microresearch/gamma/notes.org

* edition of 60. price 225

* costs - euros

- tube 12
- castings resin/casts (20 casts say 100=5+costs=10) 10
- pitchblend 12

- parts approx 15 
- thru-hole 2xswitch, 3xpoti, 5x jacks 3
- knobs x3= 2
- pcb/panel 20
- manual/cables/screws 3
- postage and packings 6+1 say= 7

excess costs say 10
production costs 20

TOTAL: 114!

* old notes here// see README.org in src

** 24/11

- gamma.c basic tests and see if need to redesign for ICP but probably not as is not so critical time-wise

- q of transistor FJN which doesn;t seem to work (BUL216 is fine) - if is just resistor Q/trim for every case?

problem was we have FJN3303R which has a resistor inside it

- programs fuse fine// TEST all TODO!

* PSU

mightyohm vs. libellium/sparkfun vs. CCFL

mightyohm equivs: 

1N4937 - NTE552
FJN3303F - STX13001/3/5, MJE13005, FJP13009, BUL216
1N914 - 1N4148 
2N3904 - 2N2222

555 must be CMOS - TLC 555 smd

NOT USE- [for CCFL use 1W 200v zeners and 10Nf 1kv caps... (also for libel/sparkfun)]

SBM-20 - 400v (350-450), dead time = 190 microsec, 4.7M anode resistance

- add LED and serial out for testing

so far on mightyohm - 16.6 k (10k+3x2.2) gives 400v approx and works fine. DECOUPLE PSU

sparkfun - works with crossover transformer (also rising edge for detection)

both seem give same kind of results with sources...

*decided on 555//mightyohm and check all versions*

* PCB

110 mm high max, width=60.6 minus ... say 50.6

* panel

*128.5 mm high // wide=12hP 60.6mm*

perspex...

size as need separate digital from HV PSU and tube!

* TODO

- PSU tests and schematic DONE - footprints to watch: switch, all transistors, fuse holder, pots, jacks...DONE

- footprints for switch, fuse-geiger holder(from gieger.brd we now have)DONE, add outline for sample holder/resin block

SMD equivs MIGHTYOHM - 555 CMOS only, 3904=MMBT3904, FJNand1N4937=noSMD - or STN0214 

- FALLING edge interrupt - test new additions following (also raw stretched geiger is protected and we have LED raw out to TEST) DONE

1ms for stretch

- note pay attention to which are HV components!

see: https://dl.dropboxusercontent.com/u/3572198/GK%20v5.5/GK%20v5.5%20Schematic.png

- sample size and placement and casting of?

* parts list and ordering info

res and some mouser switches

| 1 uF         C4        ;             
| 1.5K         R22       ; x -reichX                        
| 100K         R13       ;             
| 100K         R19       ;             
| 100K         R20       ;             
| 100N         C1        ;             
| 100N         C5        ;             
| 100N         C6        ;             
| 100N         C9        ;             
| 100N         C13       ;             
| 100N         C19       ;             
| 100N         C20       ;             
| 10K          R1        ;             
| 10K          R8        ;             
| 10K          R9        ;             
| 10K          R21       ;             
| 10N          C12       ;             
| 10nF         C21       ;             
| 10nF 1000V   C18       ; x-> mouser   S103M47Z5UN63J7RX  X       
| 10R          R16       ;             
| 10uF         C14       ; x             
| 121K         R10       ; x - reichX           
| 16 MHz       X1        ; x -reichX            
| 1K           R2        ;             
| 1K           R3        ;             
| 1K           R4        ;             
| 1K           R11       ;             
| 1K           R14       ;             
| 1K           R15       ;             
| 1K           R23       ;             
| 1K           R24       ;             
| 1N4148       D11       ; x - thru hole x -reich                                   X
| 1N4937       D10       ; x - thru hole x -reich                                   X      
| 1N914        D9        ; x - thru hole x -reichX                   
| 1nF          C17       ;             
| 1uF          C15       ;             
| 22 pF        C2        ;             
| 22 pF        C3        ;             
| 220K         R12       ; x -reich X                       
| 2n3904-smd   Q1        ; x- MMBT3904Xsegor            
| 2n3904-smd   Q3        ;             
| 330pF 1000V  C16       ; x -mouser?    S221K25Y5PN6TK5R X        
| 33K          R7        ; x -reichX                        
| 4.7M         R18       ; x -reichX                       
| 47N          C7        ; x -reichX  X7R-G0805 47N                                  
| 47N          C8        ;                                    
| 56K          R5        ; x -reichX                                   
| 56K          R6        ;             
| 6.8R         R17       ; x -reichX                                   
| 74HC14       U8        ; x -reichX                                   
| 7805         U4        ; x -reichX                                   
| AUDIO-JACKERTHENVAR_ERTHENVAR-JACK U1        ;             
| AUDIO-JACKERTHENVAR_ERTHENVAR-JACK U2        ;             
| AUDIO-JACKERTHENVAR_ERTHENVAR-JACK U5        ;             
| AUDIO-JACKERTHENVAR_ERTHENVAR-JACK U6        ;             
| AUDIO-JACKERTHENVAR_ERTHENVAR-JACK U9        ;             
| CONN_1       P3        ; pin X           
| CONN_1       P4        ; x fuse holder is mouser: 576-01020074Z x2 X
| CONN_1       P5        ; x as above            
| CONN_2       P6        ; 2pin X           
| CONN_5       P1        ; progpins X           
| CONN_5X2     P2        ; 10 pin x -reichMPE 087-2-010X                                   
| CP           C10       ; ? x 10uF           
| CP           C11       ; ? x 10uF           
| DIODE        D7        ; ? x protection as on all=  - mouser 1N5819HW-7-F X
| DIODE        D8        ; ? x           
| FJN3303F     Q2        ; x 0- mouser X           
| INDUCTOR     L1        ; x -reich  L-11P 10M X                                  
| LED          D12       ; x -reich X                                  
| MEGA48/88/168-AU IC1     x -reich  X                       ; avr-4-TQFP32-08
| POT          RV2       ;             
| POT          RV3       ;             
| SWITCH_INV   SW1       ; x-segor X            
| SWITCH_INV   SW2       ; x-segor X           
| TL072        U3        ; x -reich  TL 072 CD SMD X                                  
| TLC555N      U7        ; x -reich X                                  
| ZENER        D1        ; x incoming zeners MOUSER = input clamp now bat854sw: BAT854SW115 X
| ZENER        D2        ; 3 each            
| ZENER        D3        ;             
| ZENER        D4        ;             
| ZENER        D5        ;             
| ZENER        D6        ;             

* manual/software notes

Extending the explorations of material process and ever viral code
initiated by the micro_research ERD series, ERD/γ digs the Eurorack
synth deep into geological time scales of radioactive decay.

half life... randomness quotes... references

about pitchblende - diagram

https://en.wikipedia.org/wiki/Uraninite

add half-life tables/explain(pitchblend)... module needs to be recalibrated after
x billion years// dosage table // image photo exposure // dosage chart

software: 

jacks: trigger out, out
CV: speed, scale, trigger
pot: speed, scale

document modes on switches: 
00/ scaled random every speed time
01/ scaled random every random time scaled by speed
NO!10/ pulse 5v every x scaled random time
11/ 5v trigger in gives last random voltage
