microresearch/gamma/gamma001_revised.pdf

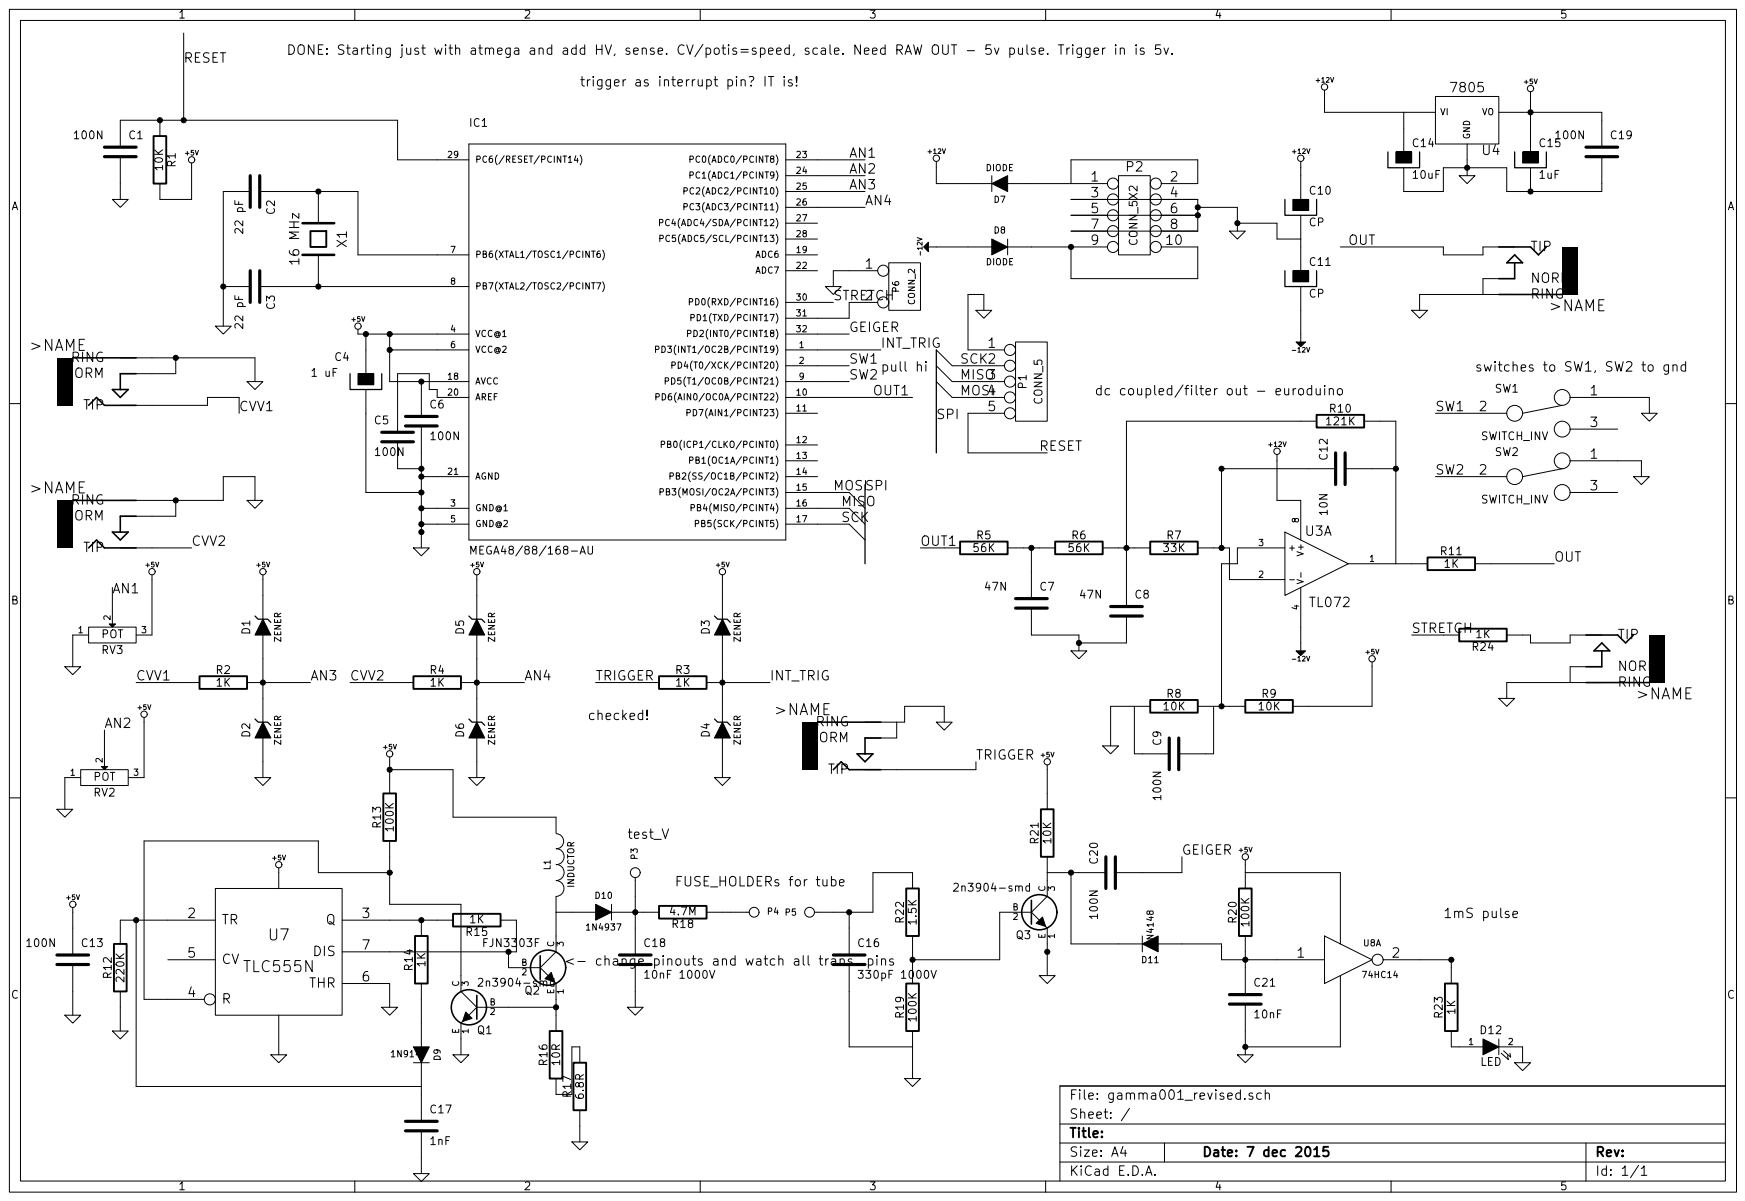
[picture p5: page 1]
