microresearch/gamma/gamma001.sch

## KiCad design gamma001.sch (2015-12-09, an earlier design)

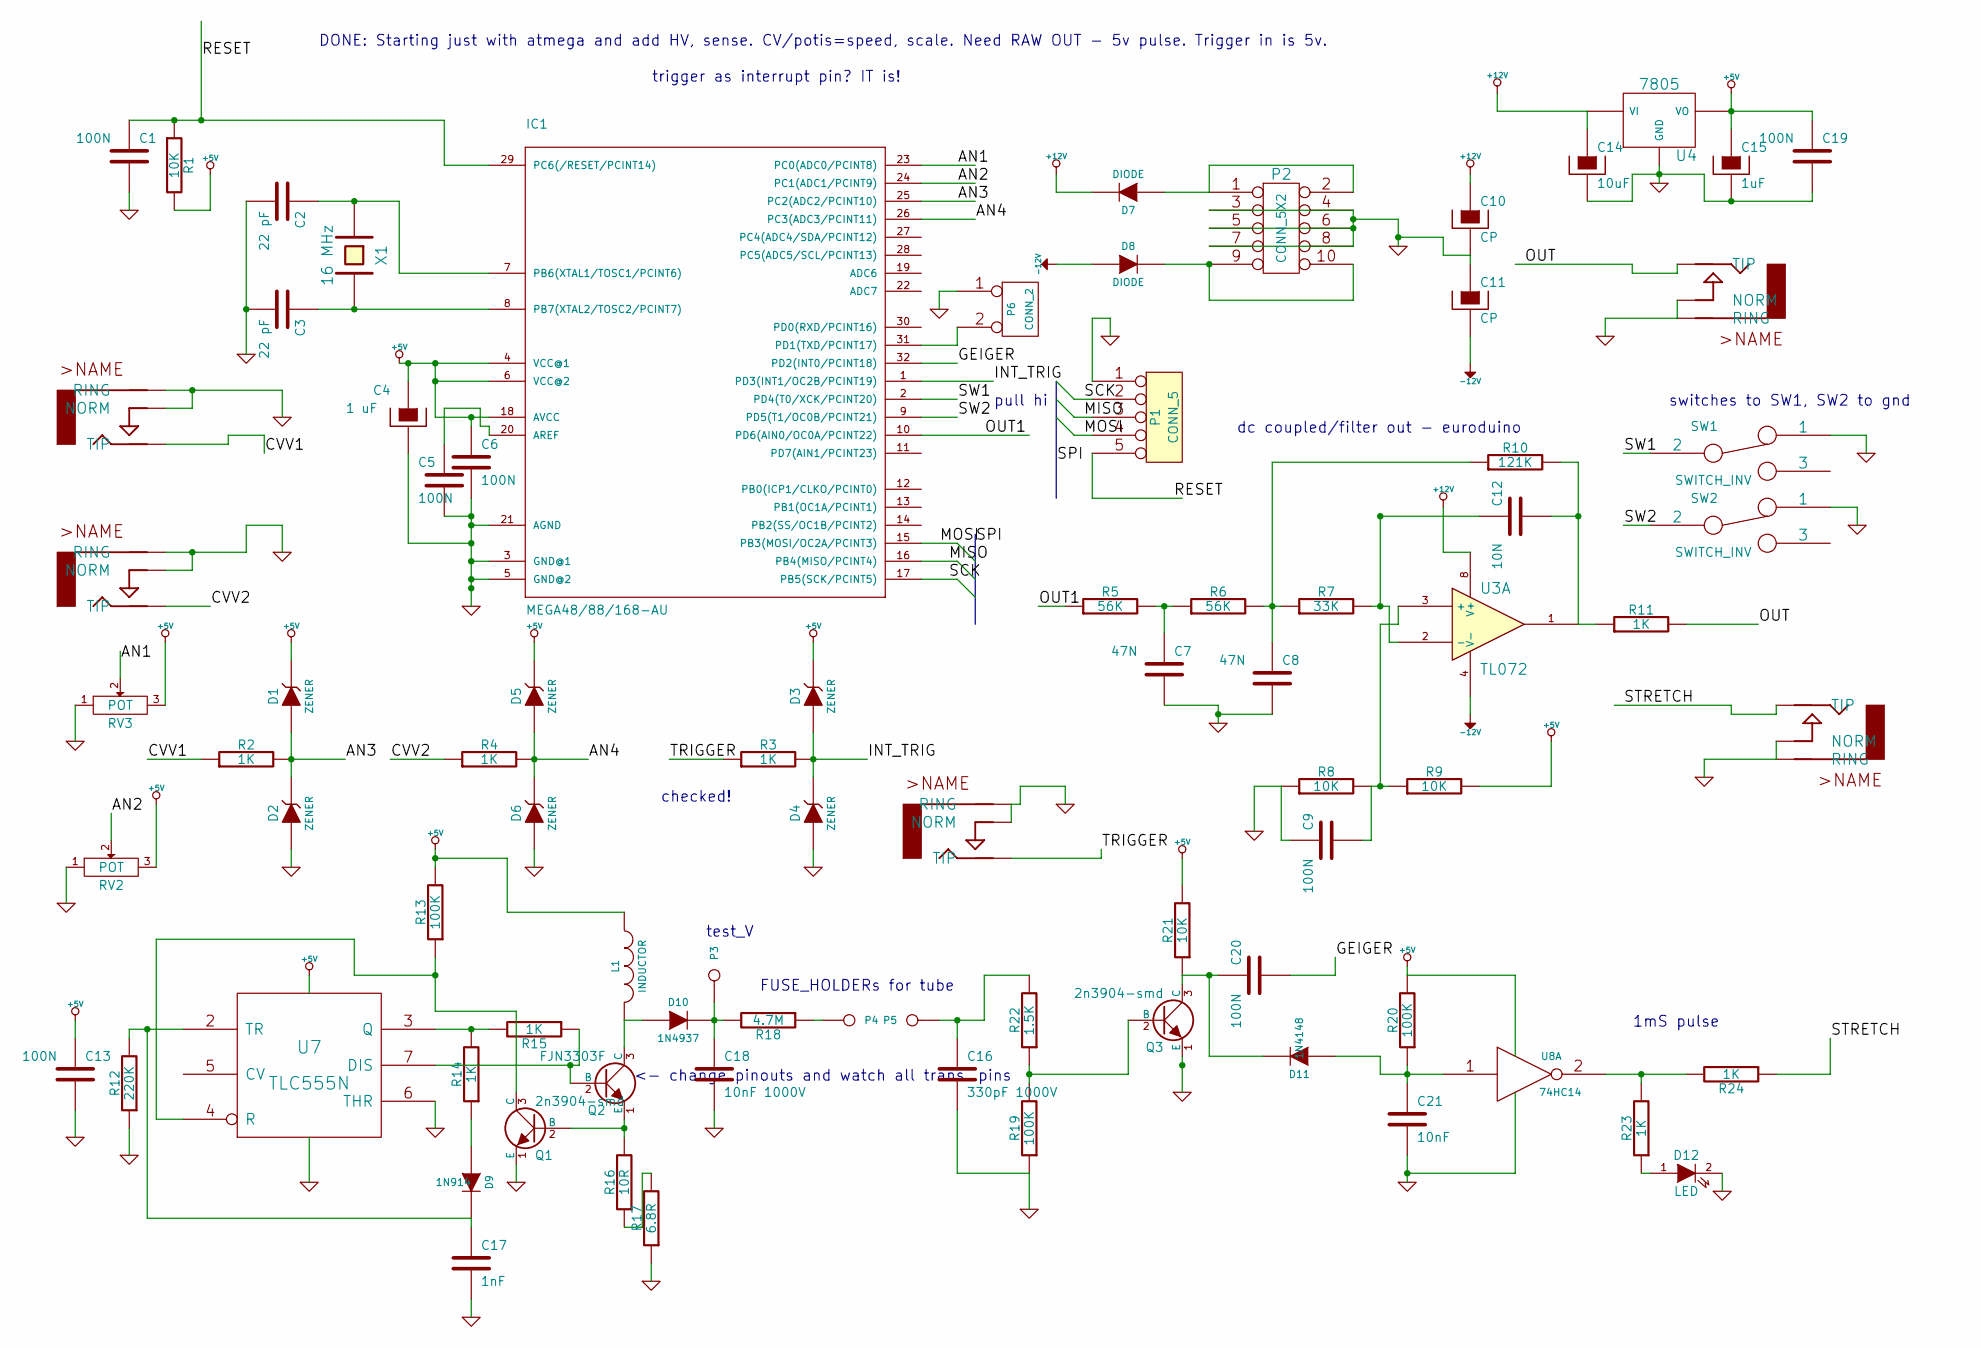
[picture p6: schematic gamma001.sch]

Parts:
C1, C5, C6, C9, C13, C19, C20: 100N
C2, C3: 22 pF
C4: 1 uF
C7, C8: 47N
C10, C11: CP
C12: 10N
C14: 10uF
C15: 1uF
C16: 330pF 1000V
C17: 1nF
C18: 10nF 1000V
C21: 10nF
D1, D2, D3, D4, D5, D6: ZENER
D7, D8: DIODE
D9: 1N914
D10: 1N4937
D11: 1N4148
D12: LED
IC1: MEGA48/88/168-AU; avr-4-TQFP32-08
L1: INDUCTOR
P1: CONN_5
P2: CONN_5X2
P3, P4, P5: CONN_1
P6: CONN_2
Q1, Q3: 2n3904-smd
Q2: FJN3303F
R1, R8, R9, R21: 10K
R2, R3, R4, R11, R14, R15, R23, R24: 1K
R5, R6: 56K
R7: 33K
R10: 121K
R12: 220K
R13, R19, R20: 100K
R16: 10R
R17: 6.8R
R18: 4.7M
R22: 1.5K
RV2, RV3: POT
SW1, SW2: SWITCH_INV
U1, U2, U5, U6, U9: AUDIO-JACKERTHENVAR_ERTHENVAR-JACK
U3: TL072
U4: 7805
U7: TLC555N
U8: 74HC14
X1: 16 MHz

Connections:
+5V: C4.1, C6.1, C13.1, C15.1, C19.1, D1.2 (K), D3.2 (K), D5.2 (K), IC1.4 (VCC@1), IC1.6 (VCC@2), IC1.18 (AVCC), L1.1, R1.2, R9.2, R13.2, R20.2, R21.2, RV2.3, RV3.3, U4.VO, U7.8 (VCC), U8.14 (VCC)
+12V: C10.1, C14.1, D7.2 (K), U3.8 (V+), U4.VI
-12V: C11.2, D8.1 (A), U3.4 (V-)
AN1: IC1.23 (PC0(ADC0/PCINT8)), RV3.2
AN2: IC1.24 (PC1(ADC1/PCINT9)), RV2.2
AN3: D1.1 (A), D2.2 (K), IC1.25 (PC2(ADC2/PCINT10)), R2.2
AN4: D5.1 (A), D6.2 (K), IC1.26 (PC3(ADC3/PCINT11)), R4.2
CVV1: R2.1, U6.3 (TIP)
CVV2: R4.1, U1.3 (TIP)
GEIGER: C20.2, IC1.32 (PD2(INT0/PCINT18))
GND: C1.2, C2.2, C3.2, C4.2, C5.2, C6.2, C7.2, C8.2, C9.1, C10.2, C11.1, C13.2, C14.2, C15.2, C16.2, C17.2, C18.2, C19.2, C21.2, D2.1 (A), D4.1 (A), D6.1 (A), D12.2 (K), IC1.3 (GND@1), IC1.5 (GND@2), IC1.21 (AGND), P1.1, P2.3, P2.4, P2.5, P2.6, P2.7, P2.8, P6.1, Q1.1 (E), Q3.1 (E), R8.1, R12.1, R17.1, R19.1, RV2.1, RV3.1, SW1.1, SW2.1, U1.1@1 (RING), U1.2 (NORM), U2.1@1 (RING), U2.2 (NORM), U4.GND, U5.1@1 (RING), U5.2 (NORM), U6.1@1 (RING), U6.2 (NORM), U7.1 (GND), U7.6 (THR), U8.7 (GND), U9.1@1 (RING), U9.2 (NORM)
INT_TRIG: D3.1 (A), D4.2 (K), IC1.1 (PD3(INT1/OC2B/PCINT19)), R3.2
MISO: IC1.16 (PB4(MISO/PCINT4)), P1.3
MOSI: IC1.15 (PB3(MOSI/OC2A/PCINT3)), P1.4
unnamed: C2.1, IC1.7 (PB6(XTAL1/TOSC1/PCINT6)), X1.1
unnamed: C3.1, IC1.8 (PB7(XTAL2/TOSC2/PCINT7)), X1.2
unnamed: C5.1, IC1.20 (AREF)
unnamed: C7.1, R5.2, R6.1
unnamed: C8.1, R6.2, R7.1, R10.1
unnamed: C9.2, R8.2, R9.1, U3.3 (+)
unnamed: C12.1, R7.2, U3.2 (-)
unnamed: C12.2, R10.2, R11.1, U3.1
unnamed: C16.1, P5.1, R22.2
unnamed: C17.1, D9.2 (K), R12.2, U7.2 (TR)
unnamed: C18.1, D10.2 (K), P3.1, R18.2
unnamed: C20.1, D11.2 (K), Q3.3 (C), R21.1
unnamed: C21.1, D11.1 (A), R20.1, U8.1
unnamed: D7.1 (A), P2.1, P2.2
unnamed: D8.2 (K), P2.9, P2.10
unnamed: D9.1 (A), R14.1
unnamed: D10.1 (A), L1.2, Q2.3 (C)
unnamed: D12.1 (A), R23.1
unnamed: IC1.31 (PD1(TXD/PCINT17)), P6.2 (PM)
unnamed: P4.1, R18.1
unnamed: Q1.2 (B), Q2.1 (E), R16.2
unnamed: Q1.3 (C), R13.1, U7.4 (R)
unnamed: Q2.2 (B), R15.1, U7.7 (DIS)
unnamed: Q3.2 (B), R19.2, R22.1
unnamed: R14.2, R15.2, U7.3 (Q)
unnamed: R16.1, R17.2
unnamed: R23.2, R24.2, U8.2
OUT: R11.2, U2.3 (TIP)
OUT1: IC1.10 (PD6(AIN0/OC0A/PCINT22)), R5.1
RESET: C1.1, IC1.29 (PC6(/RESET/PCINT14)), P1.5, R1.1
SCK: IC1.17 (PB5(SCK/PCINT5)), P1.2
STRETCH: R24.1, U9.3 (TIP)
SW1: IC1.2 (PD4(T0/XCK/PCINT20)), SW1.2
SW2: IC1.9 (PD5(T1/OC0B/PCINT21)), SW2.2
TRIGGER: R3.1, U5.3 (TIP)

Notes on the sheet:
1mS pulse
<- change pinouts and watch all trans. pins
FUSE_HOLDERs for tube
pull hi
test_V
switches to SW1, SW2 to gnd
trigger as interrupt pin? IT is!
checked!
dc coupled/filter out - euroduino
DONE: Starting just with atmega and add HV, sense. CV/potis=speed, scale. Need RAW OUT - 5v pulse. Trigger in is 5v.
