microresearch/gamma/src/cps.c

#include <stdlib.h>
#include <stdio.h>
#include <avr/io.h>
#include <avr/pgmspace.h>
#include <avr/interrupt.h>

#define F_CPU 16000000
#define BAUD 9600 

#define UART_BAUD_CALC(UART_BAUD_RATE,F_OSC) ((F_OSC)/((UART_BAUD_RATE)*16l)-1)

#define sbi(var, mask)   ((var) |= (uint8_t)(1 << mask))
#define cbi(var, mask)   ((var) &= (uint8_t)~(1 << mask))

volatile long i=0;

///============Initialize Prototypes=====================///////////////////////
void ioinit(void);      // initializes IO
static int uart_putchar(char c, FILE *stream);
uint8_t uart_getchar(void);
static FILE mystdout = FDEV_SETUP_STREAM(uart_putchar, NULL, _FDEV_SETUP_WRITE);
void delay_ms(uint16_t x); // general purpose delay
/////===================================================////////////////////////

ISR (INT0_vect) 
{		
	i++;
	//	cbi(PORTC, STATUS_LED);
}

ISR(TIMER1_OVF_vect)
{
	TCNT1 = 1;	//(256/8MHz)*(65536bits-34000)~=1.009s
	printf("counts per second: %ld  \n", i);
	i=0;
}

//=========MAIN================/////////////////////////////////////////////////
int main(void)
{
	ioinit(); //Setup IO pins and defaults
	
	delay_ms(1200); //wait to settle
	
	while(1)
	{	
	  //	sbi(PORTC, STATUS_LED);
	  //	  printf("xx");
		delay_ms(30);
	}
	
	cli();
}

////////////////////////////////////////////////////////////////////////////////
///==============Initializations=======================================/////////
////////////////////////////////////////////////////////////////////////////////
void ioinit (void)
{
    //1 = output, 0 = input
  //    DDRB = 0b11101111; //PB4 = MISO 
    //    DDRC = 0b00110001; //Output on PORTC0, PORTC4 (SDA), PORTC5 (SCL), all others are inputs
    //    DDRD = 0b11110010; //PORTD (RX on PD0), input on PD2
  DDRD=0x42; // PD6 as out and PD1 as out for serial
	
    //USART Baud rate: 9600
  UBRR0H = (uint8_t)(UART_BAUD_CALC(BAUD,F_CPU)>>8);
  UBRR0L = (uint8_t)UART_BAUD_CALC(BAUD,F_CPU); /* set baud rate */
    UCSR0B = (1<<RXEN0)|(1<<TXEN0);    
	
    stdout = &mystdout; //Required for printf init
	
    //pin change interrupt on INT0
    EICRA = (1<<ISC01);//falling edge generates interrupt
    EIMSK = (1<<INT0);
	
    // Setting Timer 1:
    // normal mode
    TCCR1A = 0x00;
    // Set to clk/256 
    TCCR1B |= (1<<CS12);
    //enable overflow interrupt
    TIMSK1 |= (1<<TOIE1);
    //load timer with a value to optimize for 1 second, (256/8MHz)*(65536bits-34000)~=1.009s
    TCNT1 = 34000;
	
    sei(); //turn on global interrupts
}

static int uart_putchar(char c, FILE *stream)
{
    if (c == '\n') uart_putchar('\r', stream);
  
    loop_until_bit_is_set(UCSR0A, UDRE0);
    UDR0 = c;
    
    return 0;
}

uint8_t uart_getchar(void)
{
    while( !(UCSR0A & (1<<RXC0)) );
    return(UDR0);
}

//General short delays
void delay_ms(uint16_t x)
{
  uint8_t y, z;
  for ( ; x > 0 ; x--){
    for ( y = 0 ; y < 40 ; y++){
      for ( z = 0 ; z < 40 ; z++){
        asm volatile ("nop");
      }
    }
  }
}
