microresearch/gamma/src/test.c

/// testing

//gcc test.c -otest -lm -std=gnu99 

#include <stdio.h>
#include <stdint.h>
#include <stdlib.h>
#include <math.h>
#include <time.h>
#include <malloc.h>

// 1/64=0.015 xx>>7

const float floaty[256]={0.0,0.015625, 0.0161451437284, 0.0166826026246, 0.0172379530968, 0.0178117907411, 0.0184047309808, 0.0190174097258, 0.0196504840553, 0.0203046329219, 0.02098055788, 0.0216789838384, 0.0224006598371, 0.0231463598515, 0.0239168836218, 0.0247130575109, 0.0255357353908, 0.026385799558, 0.0272641616801, 0.0281717637733, 0.0291095792129, 0.0300786137769, 0.0310799067249, 0.0321145319128, 0.0331835989441, 0.0342882543601, 0.0354296828696, 0.0366091086195, 0.0378277965074, 0.0390870535385, 0.040388230227, 0.0417327220447, 0.0431219709176, 0.0445574667721, 0.0460407491333, 0.0475734087755, 0.049157089429, 0.0507934895423, 0.052484364104, 0.0542315265248, 0.0560368505825, 0.0579022724313, 0.0598297926785, 0.06182147853, 0.0638794660074, 0.0660059622387, 0.0682032478254, 0.0704736792884, 0.0728196915954, 0.0752438007719, 0.0777486066003, 0.0803367954075, 0.0830111429458, 0.0857745173706, 0.0886298823154, 0.0915803000709, 0.0946289348692, 0.0977790562767, 0.101034042701, 0.104397385016, 0.1078726903, 0.111463685713, 0.115174222485, 0.119008280052, 0.122969970324, 0.12706354209, 0.131293385579, 0.135664037168, 0.140180184246, 0.144846670241, 0.149668499816, 0.154650844232, 0.159799046902, 0.165118629113, 0.170615295952, 0.176294942426, 0.182163659779, 0.18822774203, 0.194493692719, 0.200968231885, 0.207658303272, 0.214571081773, 0.221713981131, 0.229094661885, 0.236721039586, 0.244601293289, 0.252743874322, 0.261157515353, 0.269851239751, 0.278834371268, 0.2881165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

      // min or max is random... ignore scale x and we want to get fine grain for low scales...
      // so is kind of exp
      // other than float best is >> 7 -> 0 * scale=1 and without >>2 (could be third const array up to say >>4)
      // see latest gamma.c for expanded arrays

      // >>7 and multiply exponentially by scale, >>6 and mult>>>
      // but how to do as continuos???
      // all 0 at begin for fast as possible
      // then dividers *1 then scale as above
      // above *128 no need to divide

      // >>7 * xxx as below translated into lookups ????

      // random * (randomscale%speed_greaterthan0) =       int pulsefresco=(((min>>shifter[max])+1)*(sclerxxx[max]%x));


      /* solutions:
      1- piece by piece if value betwen x and y
      2- look at scale /64 and approximate
      3- below
      */


      //                  min=rand()%256;
      min=128; 
      //            max=rand()%256;
      //      int pulsefresco=(((min>>shifter[x])+1)*sclerxxx[x]);
      //      int pulsefresco=(min>>(7-(x>>5)))*(x>>2);// very close !!!! // last x exponential up
      //      int pulsefrescoM=(max>>(7-(x>>5)))*(x>>2);
      //      int pulsefrescoM=(((max>>shifter[x])+1)*sclerxxx[x]);
      //      int pulsefrescoM=(((max>>shifter[x])+1)*sclerxxx[x]);

      int pulsefresco=(float)min*floaty[x];
      int pulsefrescoM=(float)max*floaty[x];


      printf("min: %d max %d xx %d\n",pulsefresco,pulsefrescoM,(7-(x>>5)));
      //      printf("min: %d\n",pulsefresco);
 
  }


}
