microresearch/gamma/(commit log)

2015-11-06 added stretch
    [gamma001.sch]
2015-11-06 brd started
    [gamma001.brd, gamma001.sch]
2015-11-24 basis for gamma code
    [gamma001.brd, gamma001.sch]
2015-12-05 pin chnage trig oot
2015-12-21 manual corrections., code fixed
    [gamma.c]
2019-02-28 some corrections
    [gamma001_revised.brd, gamma001_revised.sch]
